ParisPianist196/eeg-stuff/frontend/src/content/pages/about.md

---
title: "About"
description: "A bit about me and this blog."
---

I am aspiring to be old one day. As I work toward that goal, I am filling in the time with projects that make my brain go vroooooom 🏎️.

## Abi Lovelace
- [GitHub](https://github.com/ParisPianist196)
- [LinkedIn](https://www.linkedin.com/in/abigail-lovelace/)
- [Portfolio](https:/portfolio.abigaillovelace.com)

## Ok, but what is this *specific* thingy about?

I bought supplies to make my own EEG around 5 years ago when I was just finishing my engineering degree. I finally have the time and brain-space-vacuum to work on the project. These are my supplies:
- Arduino Mega
- Raspberry Pi
- Cheap Oscilloscope
- Multimeter
- [JFET IC OpAmp 14DIP TL084BCN](https://www.ti.com/lit/ds/symlink/tl084.pdf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)
- Disposable Gold 9mm Cup EEG Electrode 40" 10 pack from DyMedix
- Resistors:
    - 220
    - 10k
    - 5k
    - 1M
    - 2k
    - 1k
    - 10
    - 100k
    - 100
    - 330
- Transistor (I think?) TO-92
- AD620AN
    - No luck :(( I think they just don't work

## Follow Along!
Check out [My project journal](/posts) to see my progress and what I've been doing! You can also join my discord or the excellent [Women in Neurotech](https://womeninneurotech.mn.co/) organization to watch me do this live every Saturday from 12:00PM to 1:00PM EST.
