ParisPianist196/eeg-stuff/frontend/src/content/posts/Sat082226.md

---
title: Sat, 08/22/2026 - Customize it all
author: Abigail Lovelace
pubDatetime: 2026-08-22T05:17:19Z
featured: false
draft: false
tags:
  - prototype
  - init
  - hardware
  - instrumentation
ogImage: ../../assets/images/Wiring Diagram.drawio.png
description: Switched from AD620AN to making my own instrumentation amplifier.
---
# Sat, 08.22.26 - Debugging the IC
After thinking about it for a week, I decided to make sure the IC was working correctly.

Step 1 is wiring this and instead of biasing, we're going to just ground one input and put a square wave in the other. If this works the way it *should*, the output should be the same as the square wave input. This will require a little code.

Welp, seems like the obsolete chips I got on ebay don't work very well. I'm going to try to cobble together an instrumentation amplifier from the opamps I currently have.

We did it!!
[Instrumentation amplifier link](https://www.ti.com/lit/an/sboa282a/sboa282a.pdf?ts=1787367482333)

wired up


[Amplifiers I used](https://www.ti.com/lit/ds/symlink/tl084.pdf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)

## Input

input


## Output

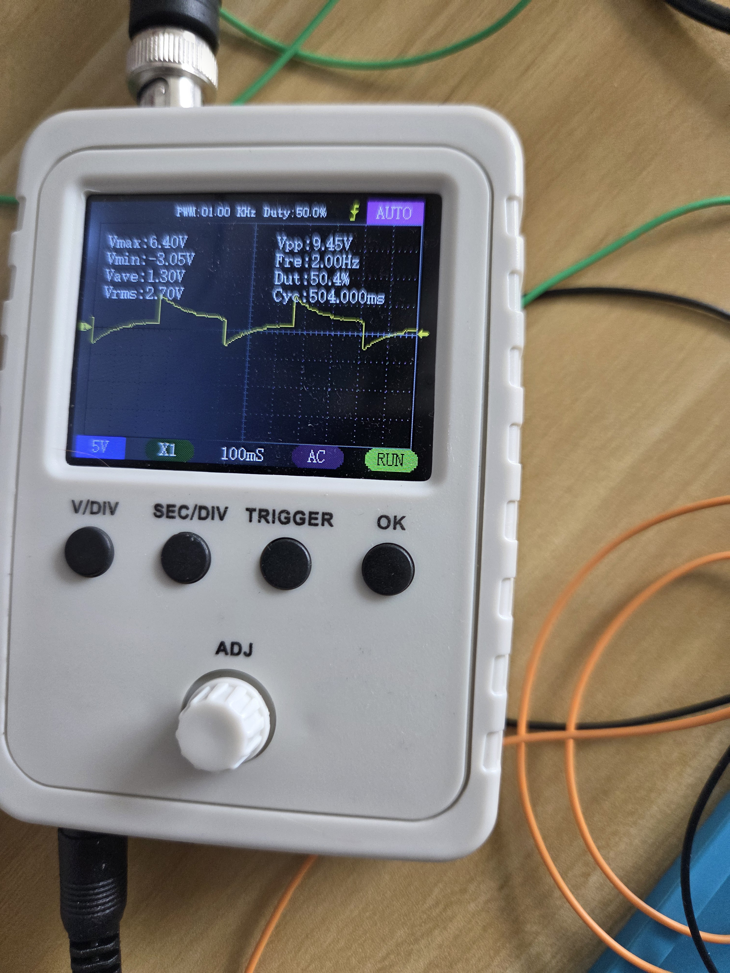
[picture p7: frontend/src/assets/images/output.jpg]


I used two 10ks to get a gain of 2x. The only weird thing is my ref is off. Gonna try to figure that one out.

Idk if the ref problem is a circuit problem or just because my oscope is so cheap and bad. I have enough to start working through the actual EEG stuff!
