ParisPianist196/eeg-stuff/frontend/src/assets/images/input1.jpg

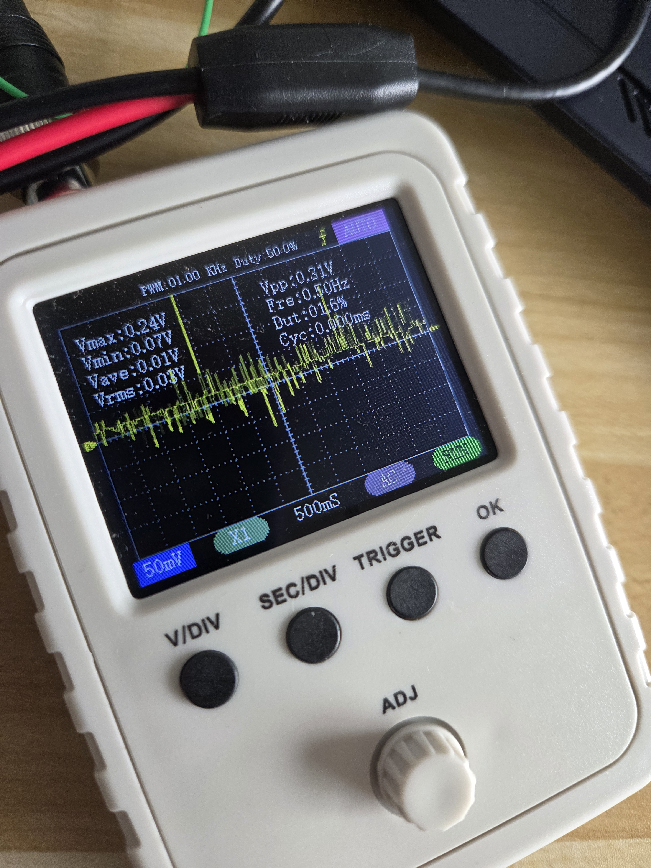
frontend/src/assets/images/input1.jpg
