ParisPianist196/eeg-stuff/frontend/src/assets/images/wiredUp.jpg

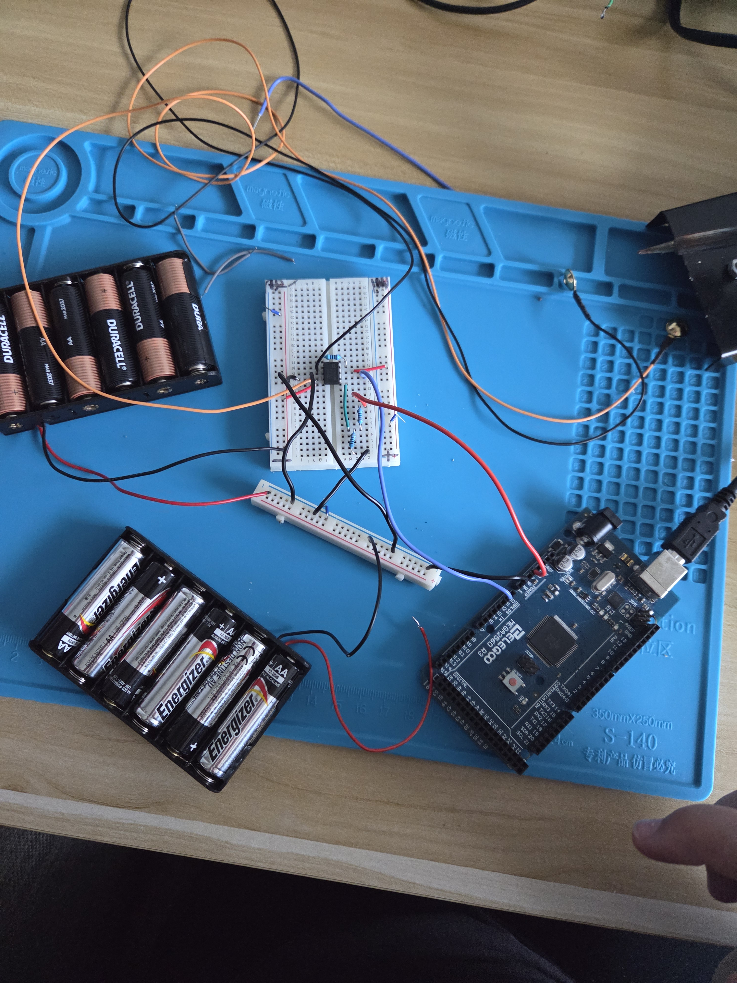
[picture p4: frontend/src/assets/images/wiredUp.jpg]
frontend/src/assets/images/wiredUp.jpg
