ParisPianist196/eeg-stuff/frontend/src/assets/images/instrumentation.jpg

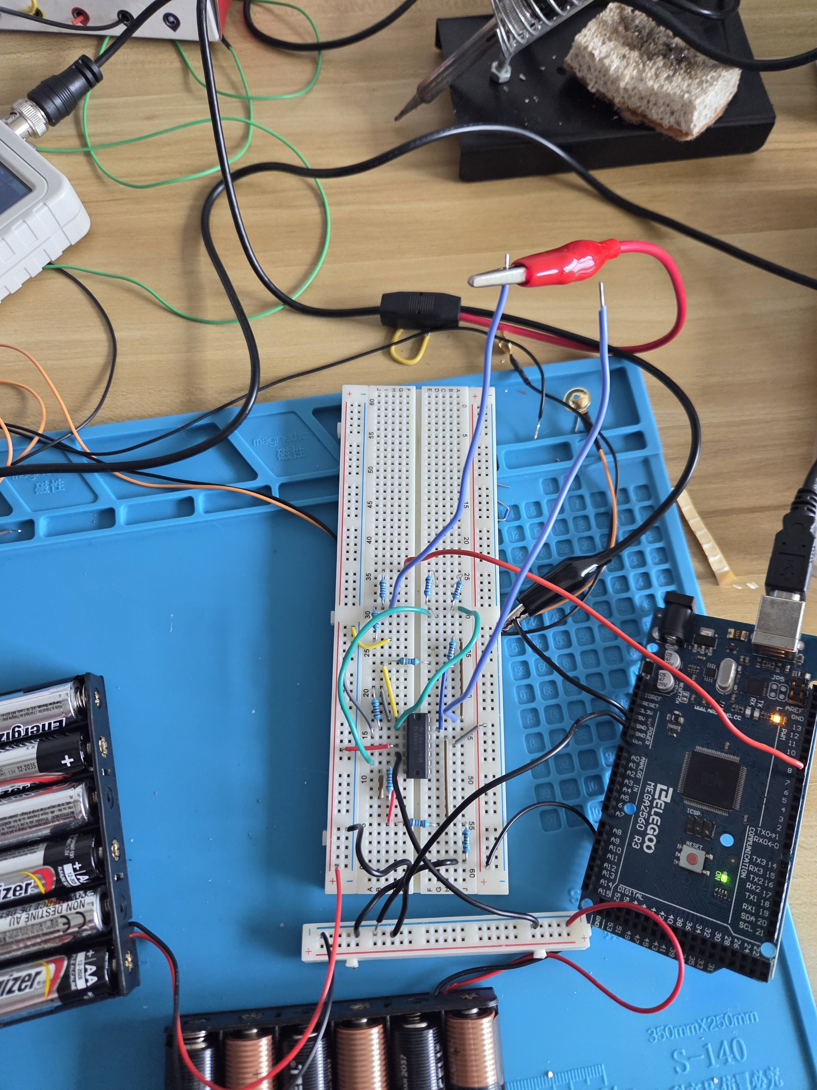
[picture p5: frontend/src/assets/images/instrumentation.jpg]
frontend/src/assets/images/instrumentation.jpg
