ParisPianist196/eeg-stuff/frontend/src/assets/images/input.jpg

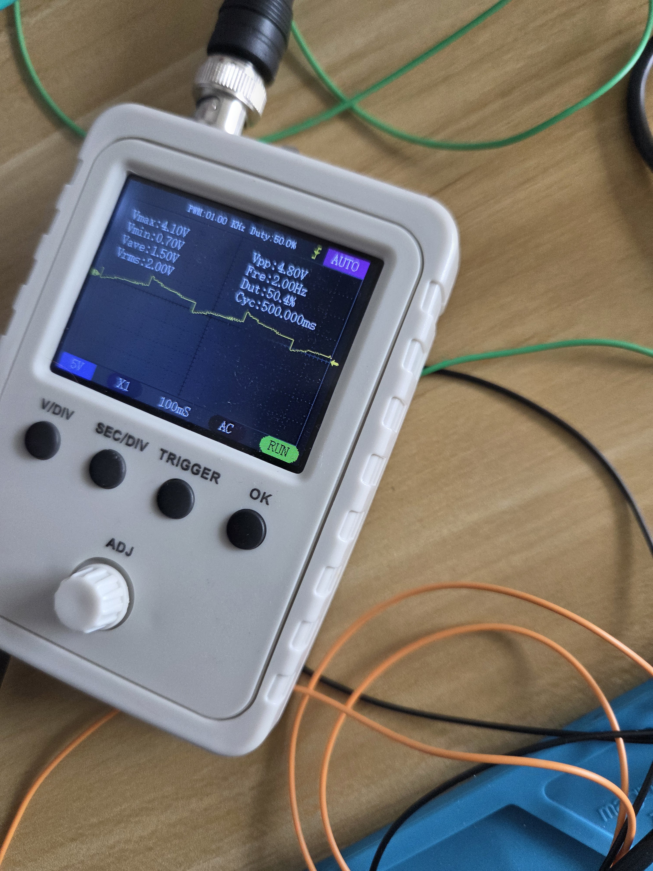
[picture p6: frontend/src/assets/images/input.jpg]
frontend/src/assets/images/input.jpg
