ParisPianist196/eeg-stuff/frontend/src/assets/images/gain.jpg

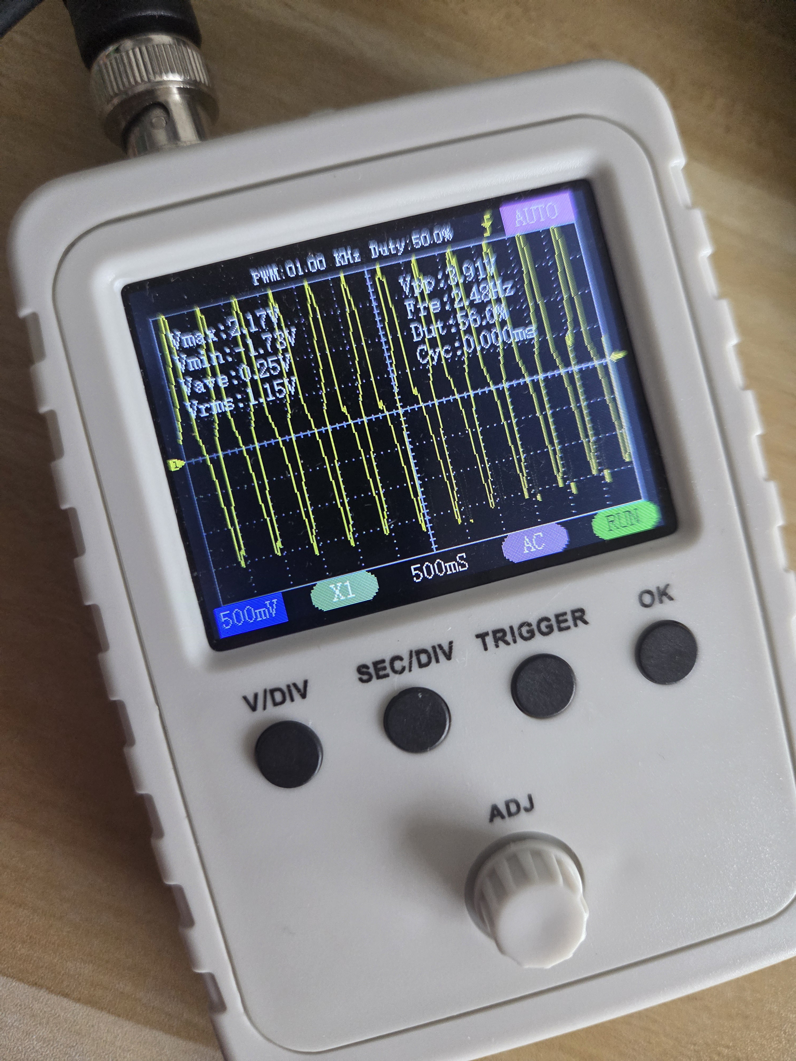
[picture p12: frontend/src/assets/images/gain.jpg]
frontend/src/assets/images/gain.jpg
