ParisPianist196/eeg-stuff/frontend/src/assets/images/hpcircuit.jpg

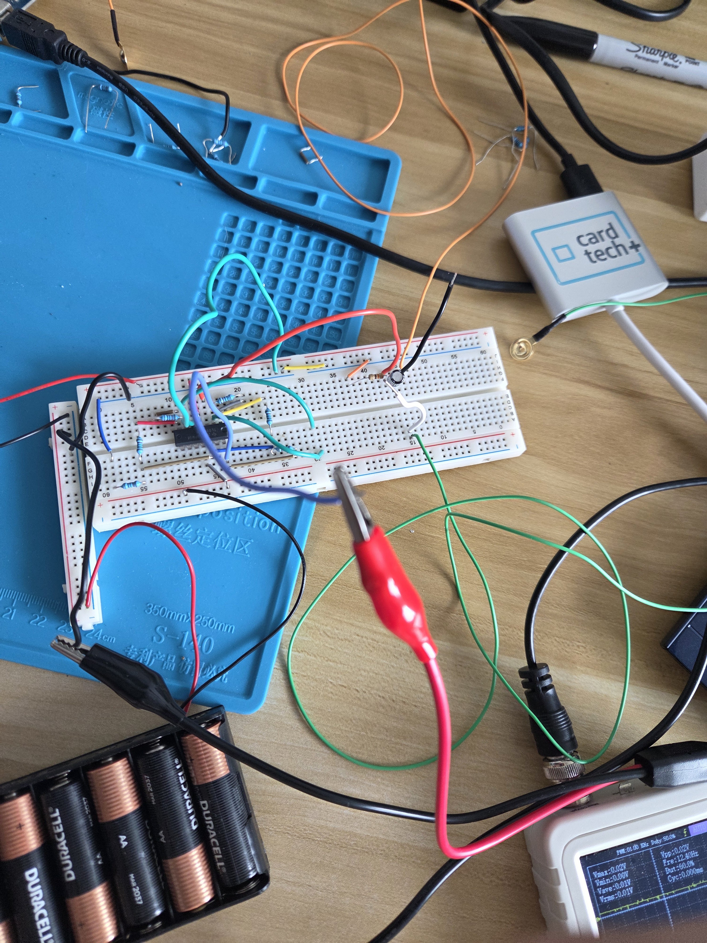
frontend/src/assets/images/hpcircuit.jpg
